CptMonkeyFist/CHIP-GameCape/README.md

# CHIP-GameCape

This is a cape being designed for the CHIP embedded computer. See the LICENSE.txt file for license details.
