CptMonkeyFist/CHIP-GameCape/Breakout.PNG

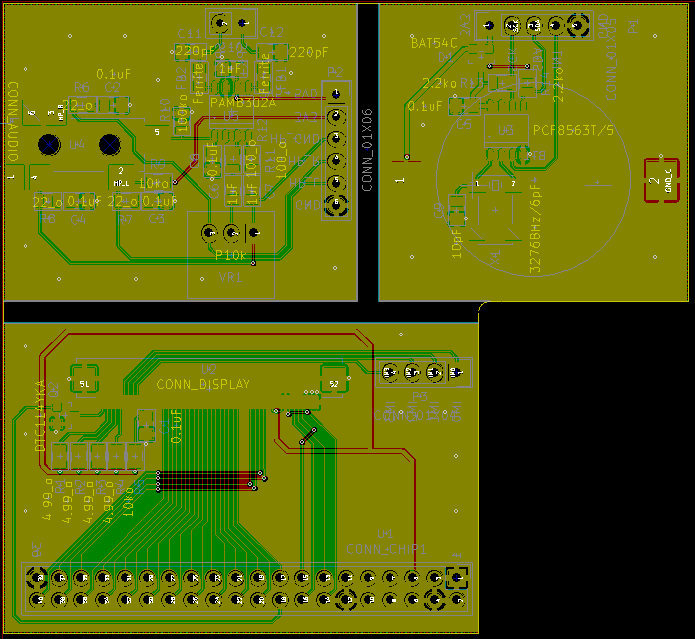
Breakout.PNG
