CptMonkeyFist/CHIP-GameCape/Datasheets/Ref Schematics/RTC_Schem.PNG

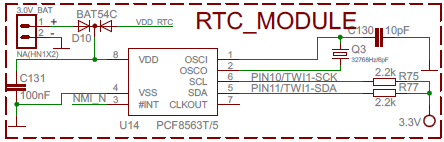
Datasheets/Ref Schematics/RTC_Schem.PNG
