CptMonkeyFist/CHIP-GameCape/Marmoset/Marmoset.xlsx

Reference | Quantity | Value | Footprint | Datasheet | Price | Price (1500) | Price per board | Price per board (1500) | Distributor Part Number | Misc | Manufacturer Part Number
C2, C3, C5, C6, C7, C10 | 6 | 0.1uF | 805 | http://www.digikey.com/product-detail/en/CL21B104KBCNNNC/1276-1003-1-ND/3889089 | 0.1 | 0.0114 | 0.6 | 0.0684 | 1276-1003-1-ND | CAP CER 0.1UF 50V 10% X7R 0805 | CL21B104KBCNNNC
R26, R27 | 2 | 100_o |  | http://www.digikey.com/product-detail/en/ERJ-6ENF1003V/P100KCCT-ND/119551 | 0.1 | 0.00729 | 0.2 | 0.01458 | P100CCT-ND | RES SMD 100 OHM 1% 1/8W 0805 | ERJ-6ENF1000V
R25 | 1 | 100ko |  | http://www.digikey.com/product-detail/en/ERJ-6ENF1003V/P100KCCT-ND/119551 | 0.1 | 0.008 | 0.1 | 0.008 | P100KCCT-ND | RES SMD 100K OHM 1% 1/8W 0805 | ERJ-6ENF1003V
R5, R6, R7, R8, R9, R10, R11, R12, R15, R16, R17, R18, R19, R20, R24 | 15 | 10ko |  | http://www.digikey.com/product-detail/en/ERJ-6ENF1002V/P10.0KCCT-ND/119248 | 0.1 | 0.00675 | 1.5 | 0.10125 | P10.0KCCT-ND | RES SMD 10K OHM 1% 1/8W 0805 | ERJ-6ENF1002V
C4 | 1 | 10pF | 805 | http://www.digikey.com/product-detail/en/CL21C100JBANNNC/1276-1109-1-ND/3889195 | 0.1 | 0.012 | 0.1 | 0.012 | 1276-1109-1-ND | CAP CER 10PF 50V 5% NP0 0805 | CL21C100JBANNNC
C8, C9, C11 | 3 | 1uF | 805 | http://www.digikey.com/product-detail/en/CL21B105KPFNNNE/1276-1275-1-ND/3889361 | 0.1 | 0.01821 | 0.3 | 0.05463 | 1276-1275-1-ND | CAP CER 1UF 10V 10% X7R 0805 | CL21B105KPFNNNE
R13, R14 | 2 | 2.2ko | 805 | http://www.digikey.com/product-detail/en/ERJ-6ENF2201V/P2.20KCCT-ND/1746832 | 0.1 | 0.008 | 0.2 | 0.016 | P2.20KCCT-ND | RES SMD 2.2K OHM 1% 1/8W 0805 | ERJ-6ENF2201V
R21, R22, R23 | 3 | 22_o |  | http://www.digikey.com/product-detail/en/ERJ-6ENF22R0V/P22.0CCT-ND/1746835 | 0.1 | 0.008 | 0.3 | 0.024 | P22.0CCT-ND | RES SMD 22 OHM 1% 1/8W 0805 | ERJ-6ENF22R0V
C12, C13 | 2 | 220pF | 805 | http://www.digikey.com/product-detail/en/samsung-electro-mechanics-america-inc/CL21C221JBANNNC/1276-1164-1-ND/3889250 | 0.1 | 0.015 | 0.2 | 0.03 | 1276-1164-1-ND | CAP CER 220pF 50V 5% X7R 0805 | CL21C221JBANNNC
X1 | 1 | 32768Hz/6pF |  | http://www.digikey.com/product-detail/en/ABS25-32.768KHZ-6-T/535-10240-1-ND/2218053 | 0.6 | 0.3192 | 0.6 | 0.3192 | 535-10240-1-ND |  | ABS25-32.768KHZ-6-T
C1 | 1 | 4.7uF |  | http://www.digikey.com/product-detail/en/CL21A475KQFNNNE/1276-1198-1-ND/3889284 | 0.14 | 0.0264 | 0.14 | 0.0264 | 1276-1198-1-ND | CAP CER 4.7UF 6.3V 10% X5R 0805 | CL21A475KQFNNNE
R1, R2, R3, R4 | 4 | 4.99_o | 805 | http://www.digikey.com/product-detail/en/RC2012F4R99CS/1276-5173-1-ND/3968145 | 0.1 | 0.00408 | 0.4 | 0.01632 | 1276-5173-1-ND | RES SMD 4.99 OHM 1% 1/8W 0805 | RC2012F4R99CS
D1 | 1 | BAT54C | SOT-23 | http://www.digikey.com/product-detail/en/BAT54C-7-F/BAT54C-FDICT-ND/717821 | 0.2 | 0.04017 | 0.2 | 0.04017 | BAT54C-FDICT-ND |  | BAT54C-7-F
BT1 | 1 | BATT_2032 |  | http://www.digikey.com/product-detail/en/BU2032SM-BT-GTR/BU2032SM-BT-GTR-ND/2439521 | 0.6 | 0.35 | 0.6 | 0.35 | BU2032SM-BT-GCT-ND | BU2032SM-BT-GTR-ND | BU2032SM-BT-GTR
U6 | 1 | CONN_AUDIO |  | http://www.digikey.com/product-detail/en/SJ-43515TS-SMT-TR/CP-43515TSSJCT-ND/669733 | 1.54 | 0.5888 | 1.54 | 0.5888 | CP-43515TSSJCT-ND | CP-43515TSSJTR-ND | SJ-43515TS-SMT-TR
U3 | 1 | CONN_BATT |  | http://www.digikey.com/product-detail/en/S2B-PH-K-S(LF)(SN)/455-1719-ND/926626 | 0.16 | 0.06836 | 0.16 | 0.06836 | 455-1719-ND | JST PH Right Angle | S2B-PH-K-S(LF)(SN)
U1 | 1 | CONN_CHIP1 |  | http://www.digikey.com/product-detail/en/M20-9762042/952-1895-ND/3727862 | 1.31 | 0.7216 | 1.31 | 0.7216 | 952-1895-ND | 2x20 0.1" | M20-9762042
U2 | 1 | CONN_CHIP2 |  | http://www.digikey.com/product-detail/en/M20-9762042/952-1895-ND/3727862 | 1.31 | 0.7216 | 1.31 | 0.7216 | 952-1895-ND | 2x20 0.1" | M20-9762042
U4 | 1 | CONN_DISPLAY |  | http://www.digikey.com/product-detail/en/62684-502100ALF/609-1202-1-ND/1003059 | 1.35 | 0.74712 | 1.35 | 0.74712 | 609-1202-1-ND |  | 62684-502100ALF
Q1, Q2 | 2 | DTC114YKA |  | http://www.digikey.com/product-detail/en/DTC114YKAT146/DTC114YKAT146CT-ND/650713 | 0.2 | 0.04017 | 0.4 | 0.08034 | DTC114YKAT146CT-ND |  | DTC114YKAT146
FB1, FB2 | 2 | Ferrite | 805 | http://www.digikey.com/product-detail/en/murata-electronics-north-america/BLM21PG121SH1D/490-12626-1-ND/5797605 | 0.17 | 0.04686 | 0.34 | 0.09372 | 490-12626-1-ND | 120 OHM @ 100 MHz 0805 3A 30mOhm | BLM21PG121SH1D
U7 | 1 | PAM8302A | SOP-8 | http://www.mouser.com/ProductDetail/Diodes-Incorporated/PAM8302AADCR/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 | 0.67 | 0.238 | 0.67 | 0.238 | 621-PAM8302AADCR | Mono Amplifier | PAM8302AADCR
U5 | 1 | PCF8563T/5 |  | http://www.digikey.com/product-detail/en/PCF8563T%2F5 | 1.21 | 0.5208 | 1.21 | 0.5208 | 568-6650-1-ND | RTC | PCF8563T/5,518/568-6650-1-ND/2617089
RV1 | 1 | POT |  | http://www.digikey.com/product-search/en/potentiometers-variable-resistors/thumbwheel-potentiometers/262240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 | 1.19 | 0.6475 | 1.19 | 0.6475 | 987-1167-ND | TRIMMER 10K OHM 3/8" CERMET TH | 91AR10KLF
SP1 | 1 | SPEAKER |  | http://www.digikey.com/product-detail/en/2403%20260%2000001/423-1171-ND/3854649 | 1.89 | 0.88518 | 1.89 | 0.88518 | 423-1171-ND |  | 2403 260 00001
BTN_UP1, BTN_DOWN1, BTN_LEFT1, BTN_RIGHT1, BTN_A1, BTN_B1, BTN_X1, BTN_Y1, BTN_START1, BTN_SEL1, BTN_POWER1, BTN_HOME1 | 12 | SW_TACT |  | http://www.digikey.com/product-detail/en/PTS525SM10SMTR%20LFS/CKN9104CT-ND/1146923 | 0.65 | 0.3498 | 7.8 | 4.1976 | CKN9104CT-ND |  | PTS525SM10SMTR LFS
BTN_L1, BTN_R1 | 2 | SW_TACT_RA |  | http://www.digikey.com/product-detail/en/B3F-3120/SW407-ND/38364 | 0.54 | 0.28995 | 1.08 | 0.5799 | SW407-ND |  | B3F-3120
Touch Screen Display | 1 |  |  | http://www.adafruit.com/products/1774 | 17.95 | 14 | 17.95 | 14 |  | Price (1500 Guess)
CHIP Computer | 1 |  |  | http://getchip.com | 9 |  | 9 | 0
Battery (2800mah) | 1 |  |  | https://www.adafruit.com/products/328 | 14.95 | 10 | 14.95 | 10 |  | Price (1500 Guess)
Injection molded case/buttons | 1 |  |  |  | 5 | 5 | 5 | 5
 |  |  |  |  |  | Total | 72.59 | 40.17147
