CptMonkeyFist/CHIP-GameCape/Schematic.pdf

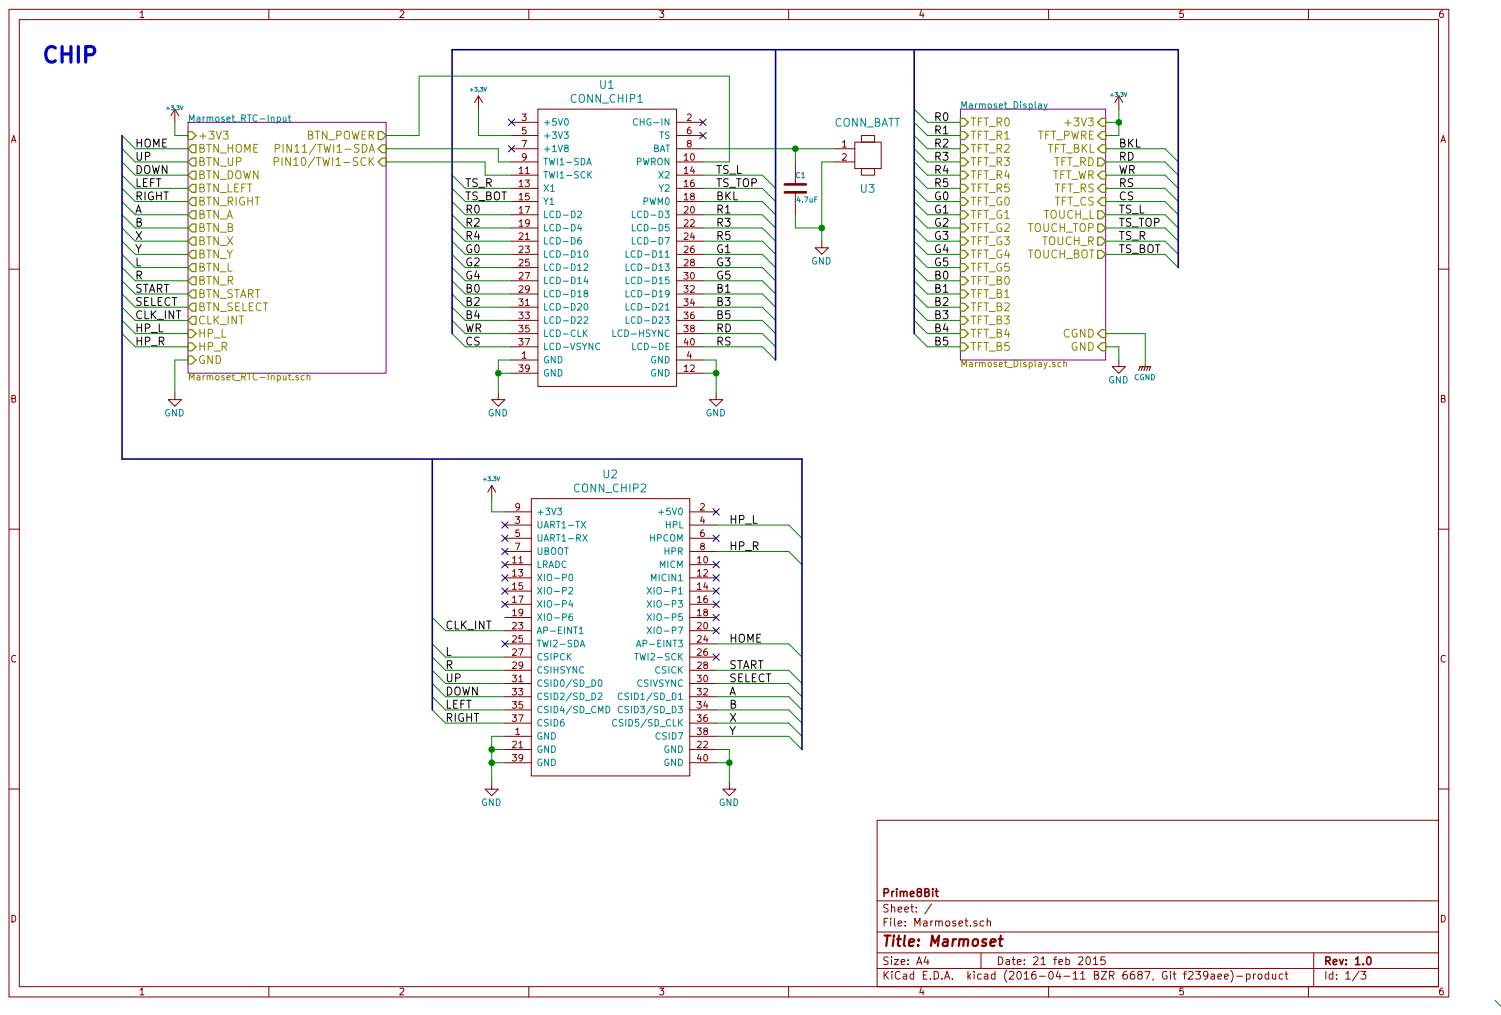
[picture p3: page 1]

Id: 1/3 Title: Marmoset File: Marmoset.sch Sheet: / Prime8Bit

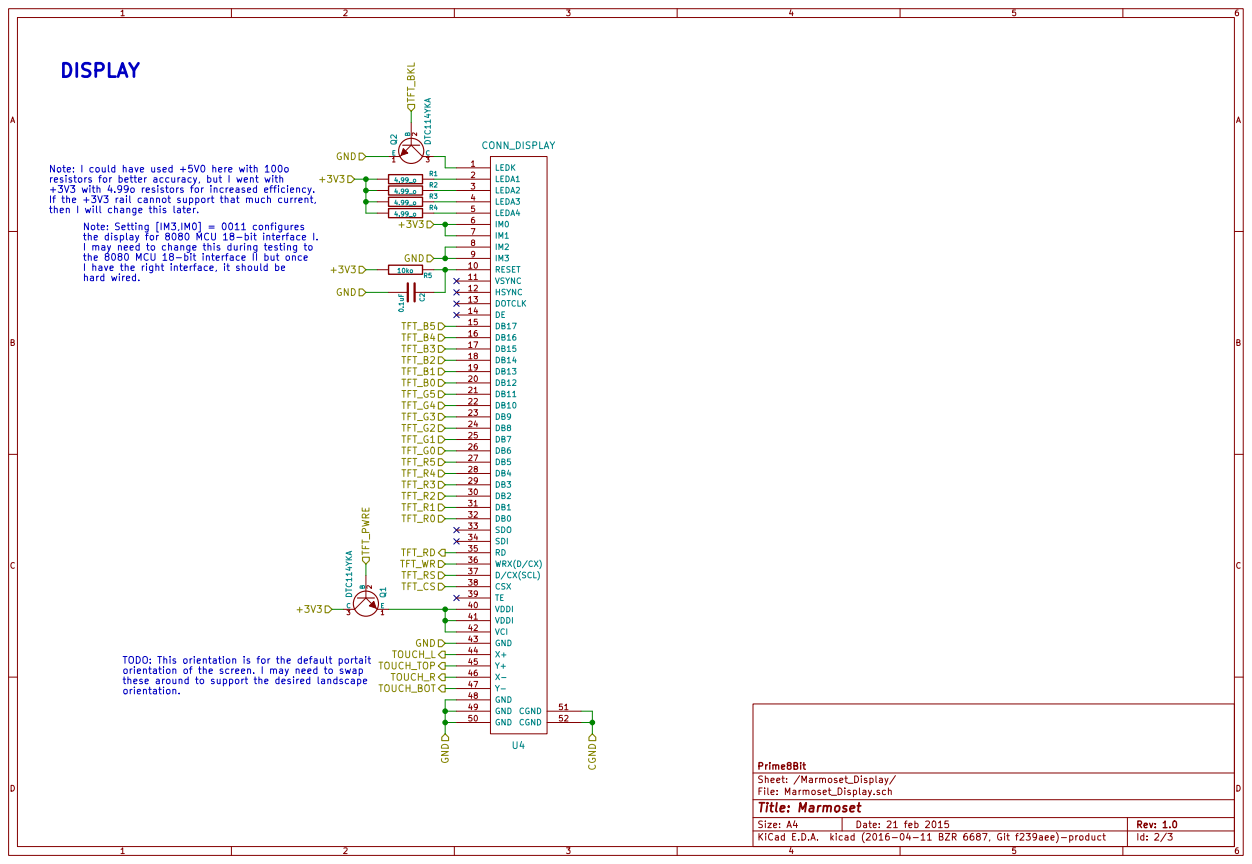
[picture p4: page 2]

Note: I could have used +5V0 here with 100o
resistors for better accuracy, but I went with
+3V3 with 4.99o resistors for increased efficiency.
If the +3V3 rail cannot support that much current,

Note: Setting [IM3,IM0] = 0011 configures
the display for 8080 MCU 18-bit interface I.
I may need to change this during testing to
the 8080 MCU 18-bit interface II but once
I have the right interface, it should be hard wired. TODO: This orientation is for the default portait

orientation of the screen. I may need to swap
these around to support the desired landscape orientation.

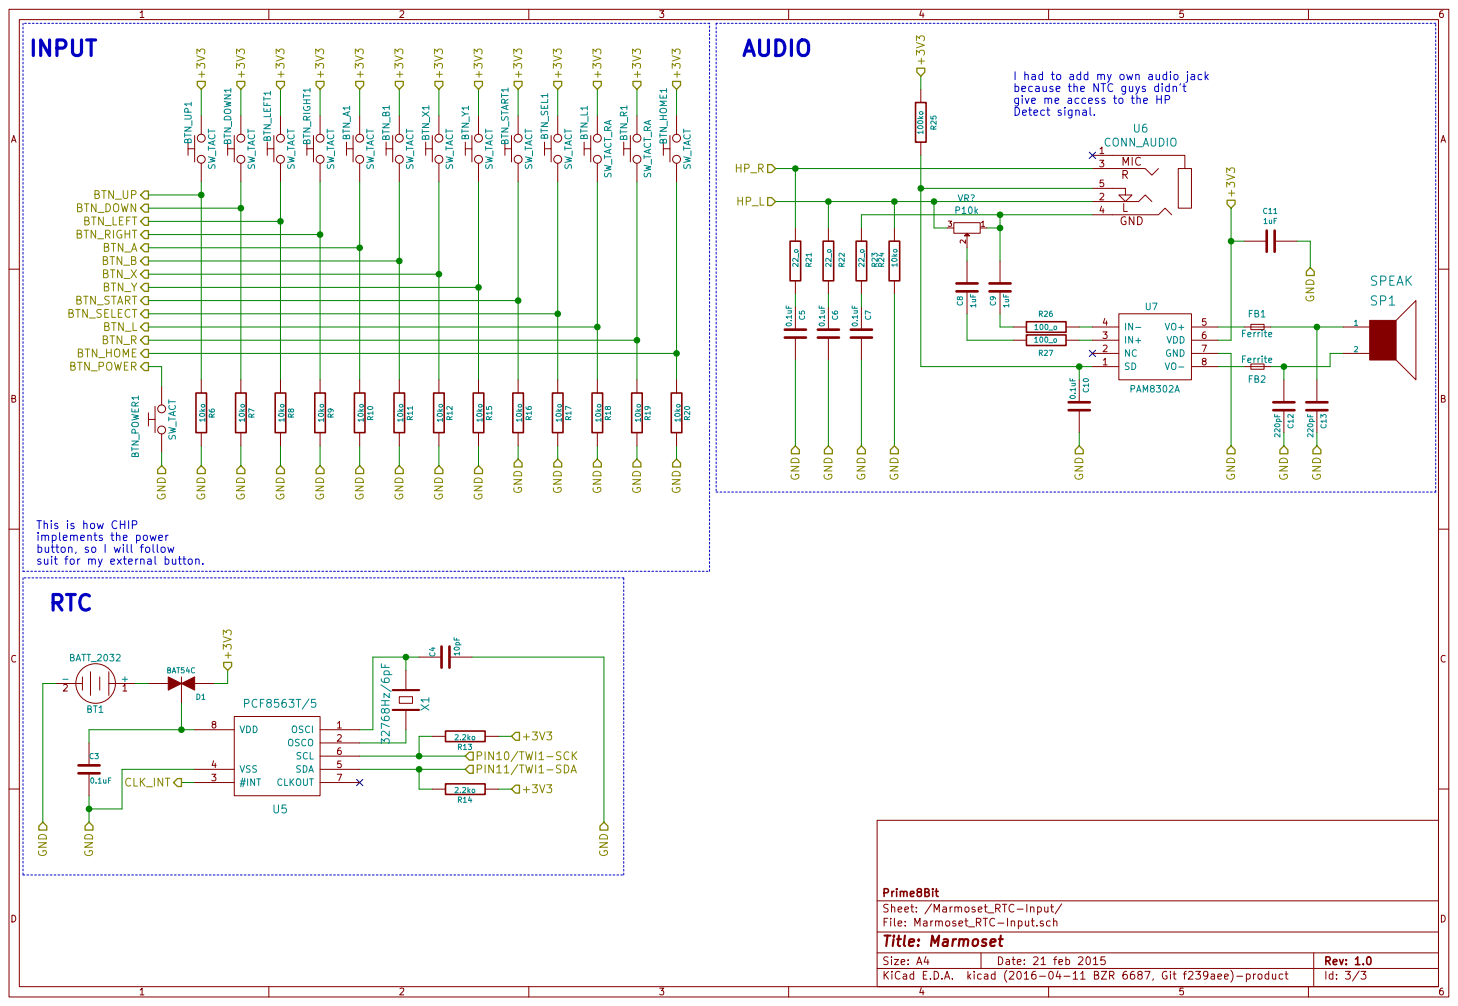
[picture p5: page 3]

I had to add my own audio jack
because the NTC guys didn't
give me access to the HP
Detect signal.

This is how CHIP
implements the power
button, so I will follow
suit for my external button.
RTC
