CptMonkeyFist/CHIP-GameCape/Marmoset_Breakout_Schem.pdf

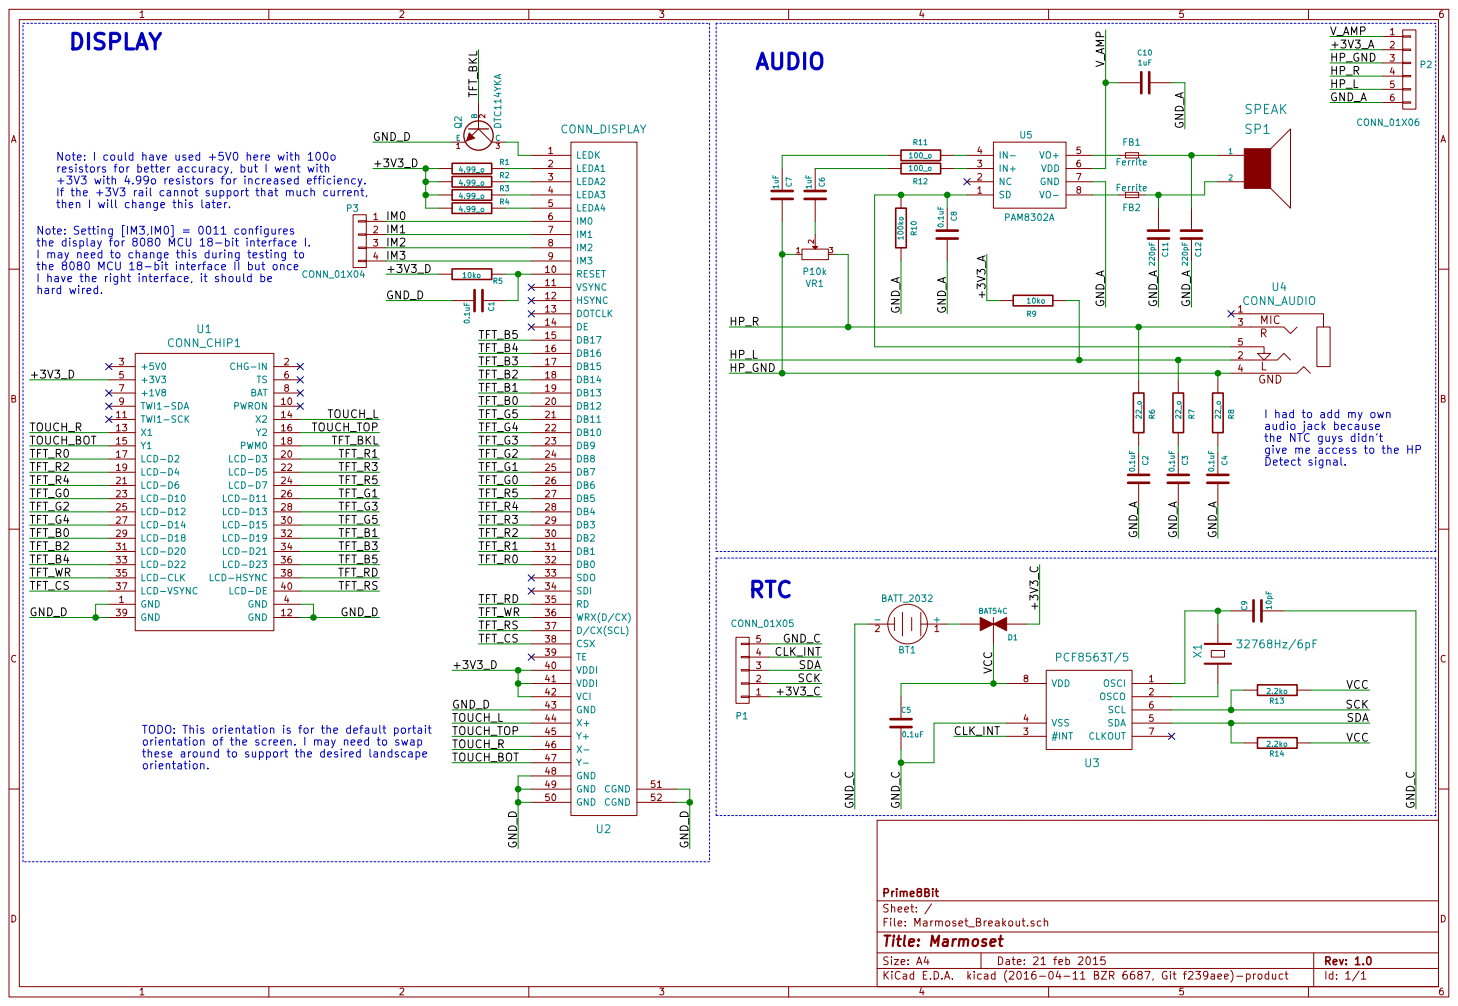
[picture p6: page 1]
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

4 P3 CONN_01X04 2 | IM1 | IM1 7

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

3 | IM2 | IM2 8
IM3

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

TFT_WR | | TFT_RD
TFT_CS | TFT_RS

TOUCH_L
TOUCH_TOP
TOUCH_R
TOUCH_BOT

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
