CptMonkeyFist/CHIP-GameCape/Marmoset_B.pdf

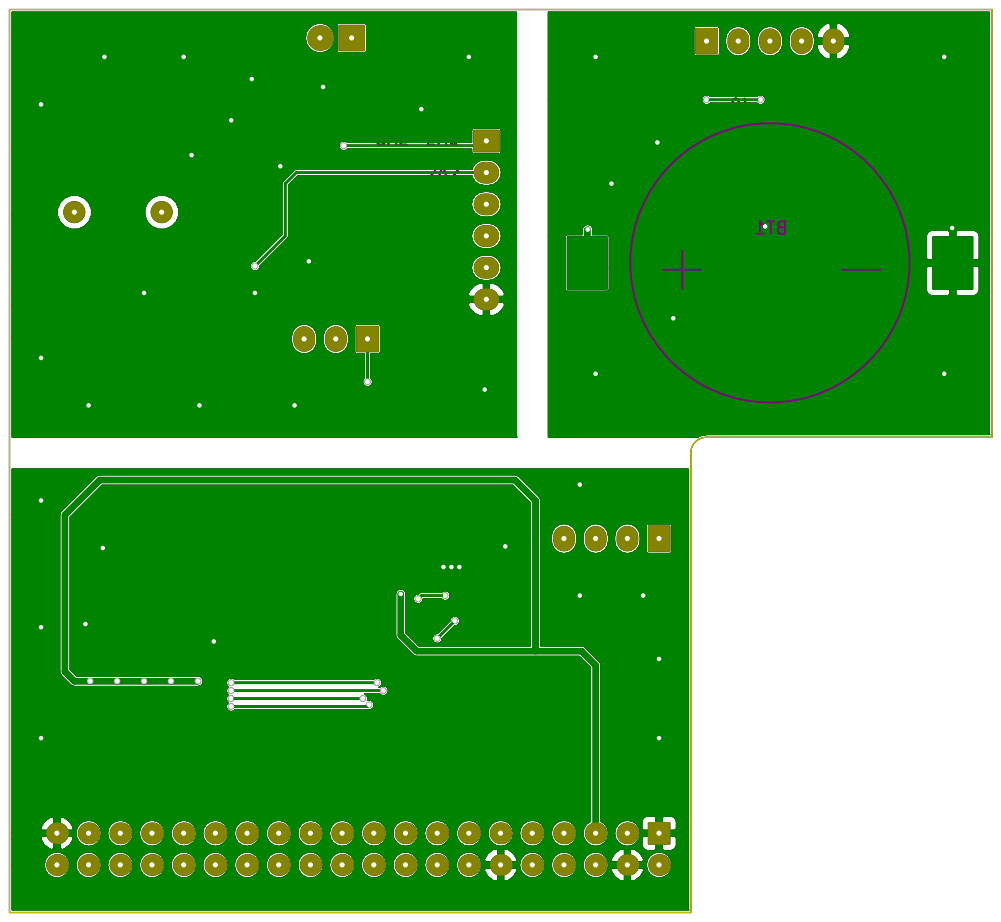
[picture p7: page 1]
