CptMonkeyFist/CHIP-GameCape/Marmoset_F.pdf

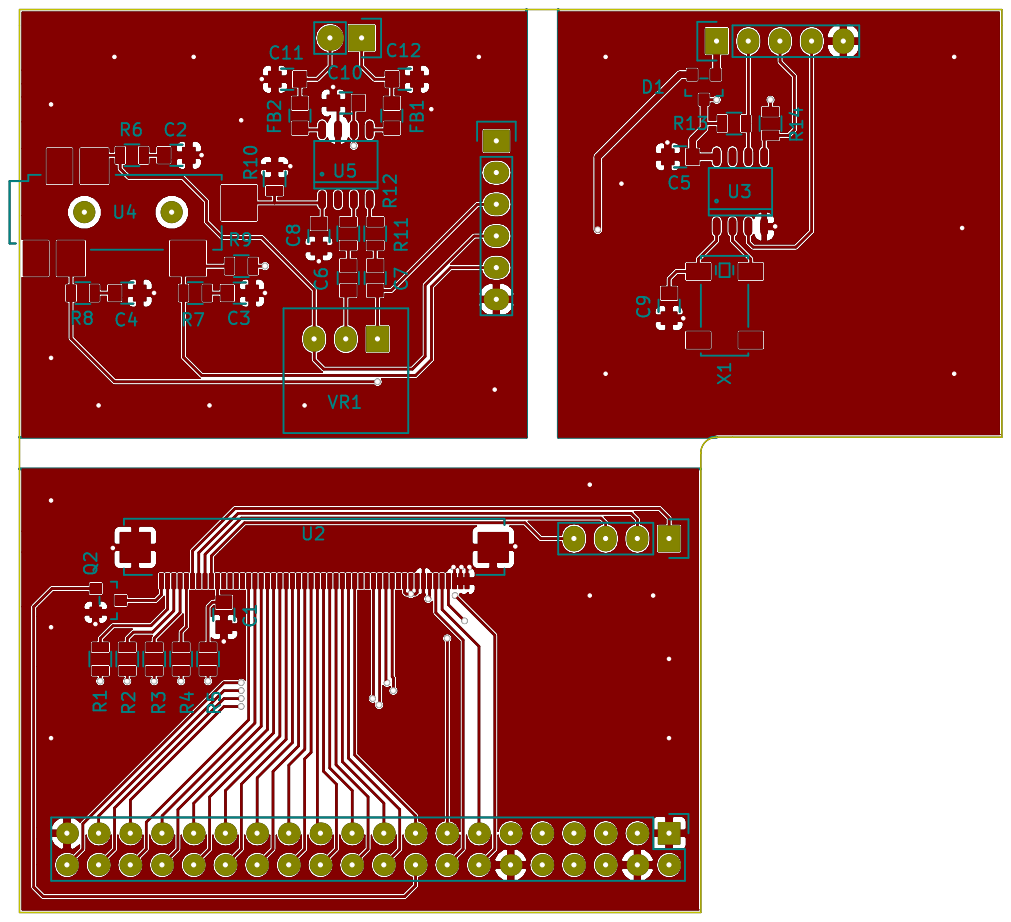
[picture p8: page 1]
