CptMonkeyFist/CHIP-GameCape/Marmoset_Breakout/Marmoset_Breakout.kicad_pcb

## KiCad design Marmoset_Breakout/Marmoset_Breakout.kicad_pcb (2016-07-28)

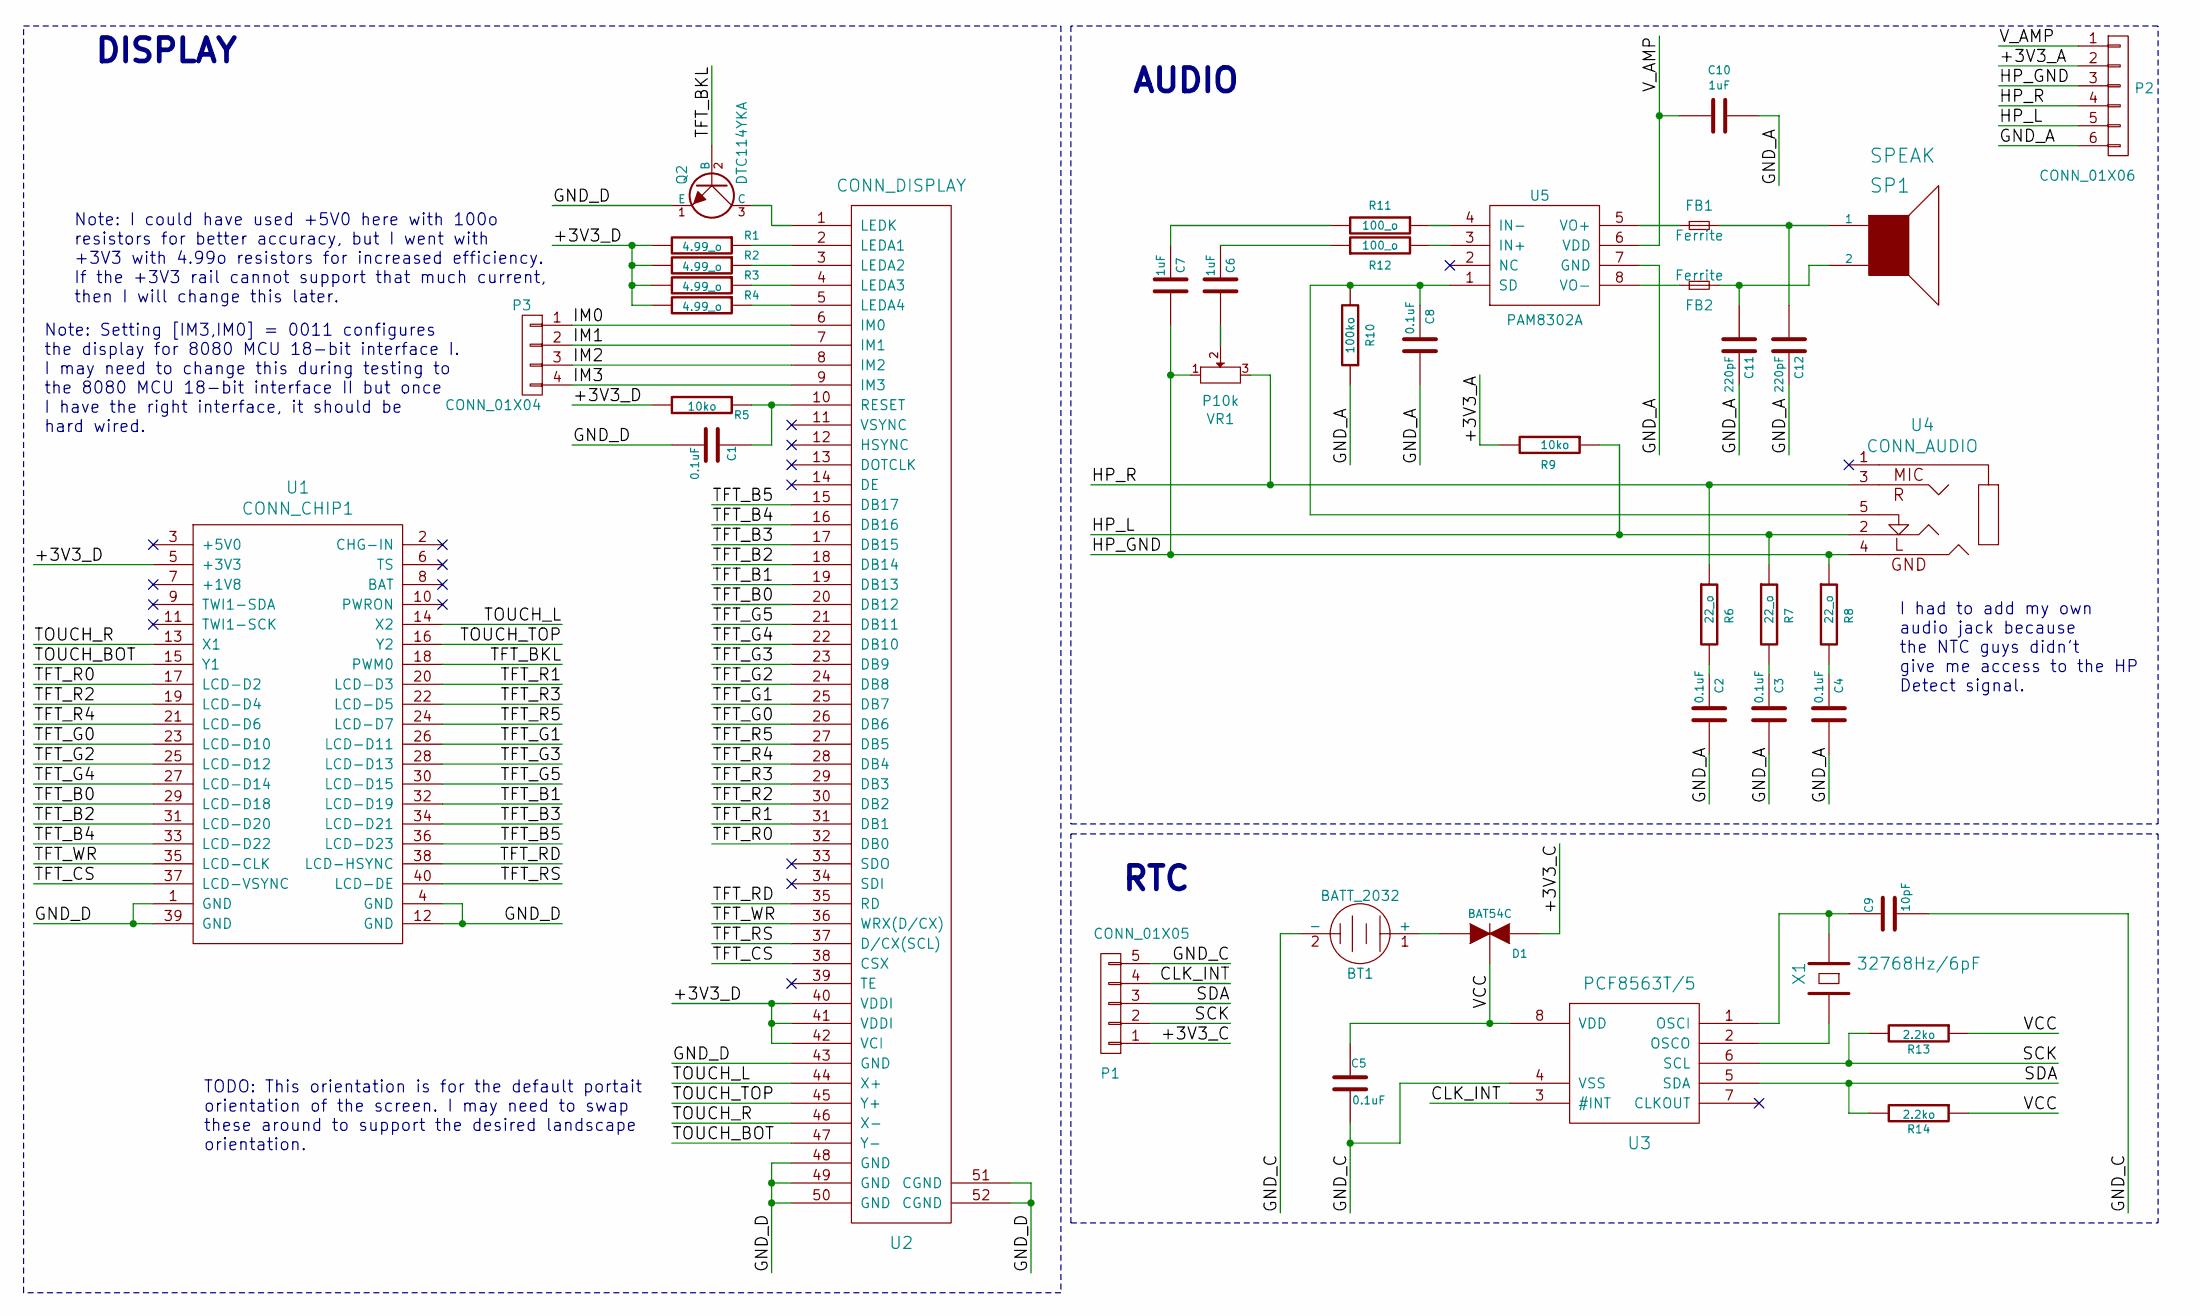
[picture p9: schematic Marmoset_Breakout.sch, Marmoset]

Parts:
BT1: BATT_2032; SMTU2032-LF; Manufacturer Part Number BU2032SM-BT-GTR
C1, C2, C3, C4, C5, C8: 0.1uF; C_0805; Manufacturer Part Number CL21B104KBCNNNC
C6, C7, C10: 1uF; C_0805; Manufacturer Part Number CL21B105KPFNNNE
C9: 10pF; C_0805; Manufacturer Part Number CL21C100JBANNNC
C11, C12: 220pF; C_0805; Manufacturer Part Number CL21C221JBANNNC
D1: BAT54C; SOT-23-3; Manufacturer Part Number BAT54C-7-F
FB1, FB2: Ferrite; C_0805; Manufacturer Part Number BLM21PG121SH1D
P1: CONN_01X05; Pin_Header_Straight_1x05
P2: CONN_01X06; Pin_Header_Straight_1x06
P3: CONN_01X04; Pin_Header_Straight_1x04
Q2: DTC114YKA; SOT-23-3; Manufacturer Part Number DTC114YKAT146
R1, R2, R3, R4: 4.99_o; R_0805; Manufacturer Part Number RC2012F4R99CS
R5, R9: 10ko; R_0805; Manufacturer Part Number ERJ-6ENF1002V
R6, R7, R8: 22_o; R_0805; Manufacturer Part Number ERJ-6ENF22R0V
R10: 100ko; R_0805; Manufacturer Part Number ERJ-6ENF1003V
R11, R12: 100_o; R_0805; Manufacturer Part Number ERJ-6ENF1000V
R13, R14: 2.2ko; R_0805; Manufacturer Part Number ERJ-6ENF2201V
SP1: SPEAK; Pin_Header_Straight_1x02; Manufacturer Part Number 2403 260 00001
U1: CONN_CHIP1; Pin_Header_Straight_2x20; Manufacturer Part Number M20-9762042
U2: CONN_DISPLAY; Manufacturer Part Number 62684-502100ALF
U3: PCF8563T/5; SO-8; Manufacturer Part Number PCF8563T/5
U4: CONN_AUDIO; CONN_HP; Manufacturer Part Number SJ-43515TS-SMT-TR
U5: PAM8302A; SO-8; Manufacturer Part Number PAM8302AADCR
VR1: P10k; Thumb_Pot; Manufacturer Part Number 91AR10KLF
X1: 32768Hz/6pF; ABS25; Manufacturer Part Number ABS25-32.768KHZ-6-T

Connections:
/+3V3_A: P2.2, R9.2
/+3V3_C: D1.2 (A), P1.1
/+3V3_D: R1.2, R2.2, R3.2, R4.2, R5.2, U1.5 (+3V3), U2.40 (VDDI), U2.41 (VDDI), U2.42 (VCI)
/CLK_INT: P1.4, U3.3 (#INT)
/GND_A: C2.2, C3.2, C4.2, C8.2, C10.1, C11.1, C12.1, P2.6, R10.1, U5.7 (GND)
/GND_C: BT1.2 (-), C5.2, C9.2, P1.5, U3.4 (VSS)
/GND_D: C1.2, Q2.1 (E), U1.1 (GND), U1.4 (GND), U1.12 (GND), U1.39 (GND), U2.43 (GND), U2.48 (GND), U2.49 (GND), U2.50 (GND), U2.51 (CGND), U2.52 (CGND)
/HP_GND: C7.2, P2.3, R8.1, U4.4, VR1.1
/HP_L: P2.5, R7.1, R9.1, U4.2
/HP_R: P2.4, R6.1, U4.3, VR1.3
/IM0: P3.1, U2.6 (IM0)
/IM1: P3.2, U2.7 (IM1)
/IM2: P3.3, U2.8 (IM2)
/IM3: P3.4, U2.9 (IM3)
/SCK: P1.2, R13.2, U3.6 (SCL)
/SDA: P1.3, R14.2, U3.5 (SDA)
/TFT_B0: U1.29 (LCD-D18), U2.20 (DB12)
/TFT_B1: U1.32 (LCD-D19), U2.19 (DB13)
/TFT_B2: U1.31 (LCD-D20), U2.18 (DB14)
/TFT_B3: U1.34 (LCD-D21), U2.17 (DB15)
/TFT_B4: U1.33 (LCD-D22), U2.16 (DB16)
/TFT_B5: U1.36 (LCD-D23), U2.15 (DB17)
/TFT_BKL: Q2.2 (B), U1.18 (PWM0)
/TFT_CS: U1.37 (LCD-VSYNC), U2.38 (CSX)
/TFT_G0: U1.23 (LCD-D10), U2.26 (DB6)
/TFT_G1: U1.26 (LCD-D11), U2.25 (DB7)
/TFT_G2: U1.25 (LCD-D12), U2.24 (DB8)
/TFT_G3: U1.28 (LCD-D13), U2.23 (DB9)
/TFT_G4: U1.27 (LCD-D14), U2.22 (DB10)
/TFT_G5: U1.30 (LCD-D15), U2.21 (DB11)
/TFT_R0: U1.17 (LCD-D2), U2.32 (DB0)
/TFT_R1: U1.20 (LCD-D3), U2.31 (DB1)
/TFT_R2: U1.19 (LCD-D4), U2.30 (DB2)
/TFT_R3: U1.22 (LCD-D5), U2.29 (DB3)
/TFT_R4: U1.21 (LCD-D6), U2.28 (DB4)
/TFT_R5: U1.24 (LCD-D7), U2.27 (DB5)
/TFT_RD: U1.38 (LCD-HSYNC), U2.35 (RD)
/TFT_RS: U1.40 (LCD-DE), U2.37 (D/CX(SCL))
/TFT_WR: U1.35 (LCD-CLK), U2.36 (WRX(D/CX))
/TOUCH_BOT: U1.15 (Y1), U2.47 (Y-)
/TOUCH_L: U1.14 (X2), U2.44 (X+)
/TOUCH_R: U1.13 (X1), U2.46 (X-)
/TOUCH_TOP: U1.16 (Y2), U2.45 (Y+)
/VCC: C5.1, D1.3 (K), R13.1, R14.1, U3.8 (VDD)
/V_AMP: C10.2, P2.1, U5.6 (VDD)
unnamed: BT1.1 (+), D1.1 (A)
unnamed: C1.1, R5.1, U2.10 (RESET)
unnamed: C2.1, R6.2
unnamed: C3.1, R7.2
unnamed: C4.1, R8.2
unnamed: C6.1, R12.1
unnamed: C6.2, VR1.2
unnamed: C7.1, R11.2
unnamed: C8.1, R10.2, U4.5, U5.1 (SD)
unnamed: C9.1, U3.1 (OSCI), X1.1
unnamed: C11.2, FB2.2, SP1.2
unnamed: C12.2, FB1.2, SP1.1
unnamed: FB1.1, U5.5 (VO+)
unnamed: FB2.1, U5.8 (VO-)
unnamed: Q2.3 (C), U2.1 (LEDK)
unnamed: R1.1, U2.2 (LEDA1)
unnamed: R2.1, U2.3 (LEDA2)
unnamed: R3.1, U2.4 (LEDA3)
unnamed: R4.1, U2.5 (LEDA4)
unnamed: R11.1, U5.4 (IN-)
unnamed: R12.2, U5.3 (IN+)
unnamed: U3.2 (OSCO), X1.2

Notes on the sheet:
Note: Setting [IM3,IM0] = 0011 configures the display for 8080 MCU 18-bit interface I. I may need to change this during testing to the 8080 MCU 18-bit interface II but once I have the right interface, it should be hard wired.
TODO: This orientation is for the default portait orientation of the screen. I may need to swap these around to support the desired landscape orientation.
Note: I could have used +5V0 here with 100o resistors for better accuracy, but I went with +3V3 with 4.99o resistors for increased efficiency. If the +3V3 rail cannot support that much current, then I will change this later.
DISPLAY
AUDIO
I had to add my own audio jack because the NTC guys didn't give me access to the HP Detect signal.
RTC

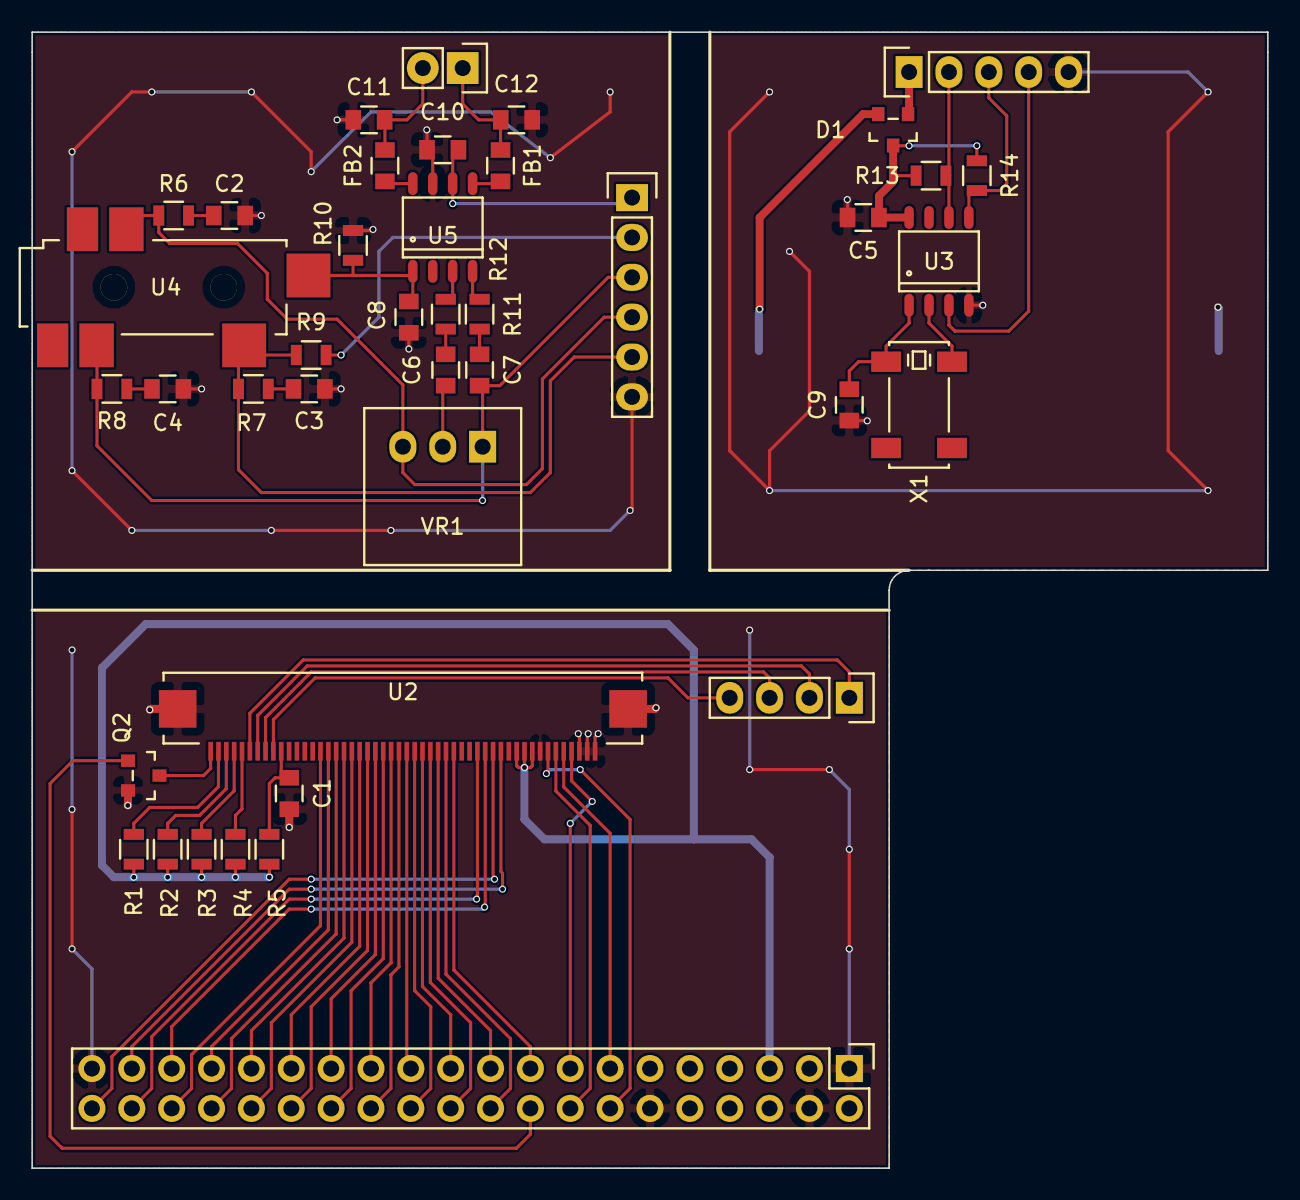
[picture p10: board Marmoset_Breakout.kicad_pcb from above]

Board: 2 copper layers, 78.7 x 72.4 mm, 42 parts (1 on the bottom side), 67 nets.
