CptMonkeyFist/CHIP-GameCape/Marmoset_Breakout/Marmoset.kicad_pcb

## KiCad design Marmoset_Breakout/Marmoset.kicad_pcb (2016-06-14)

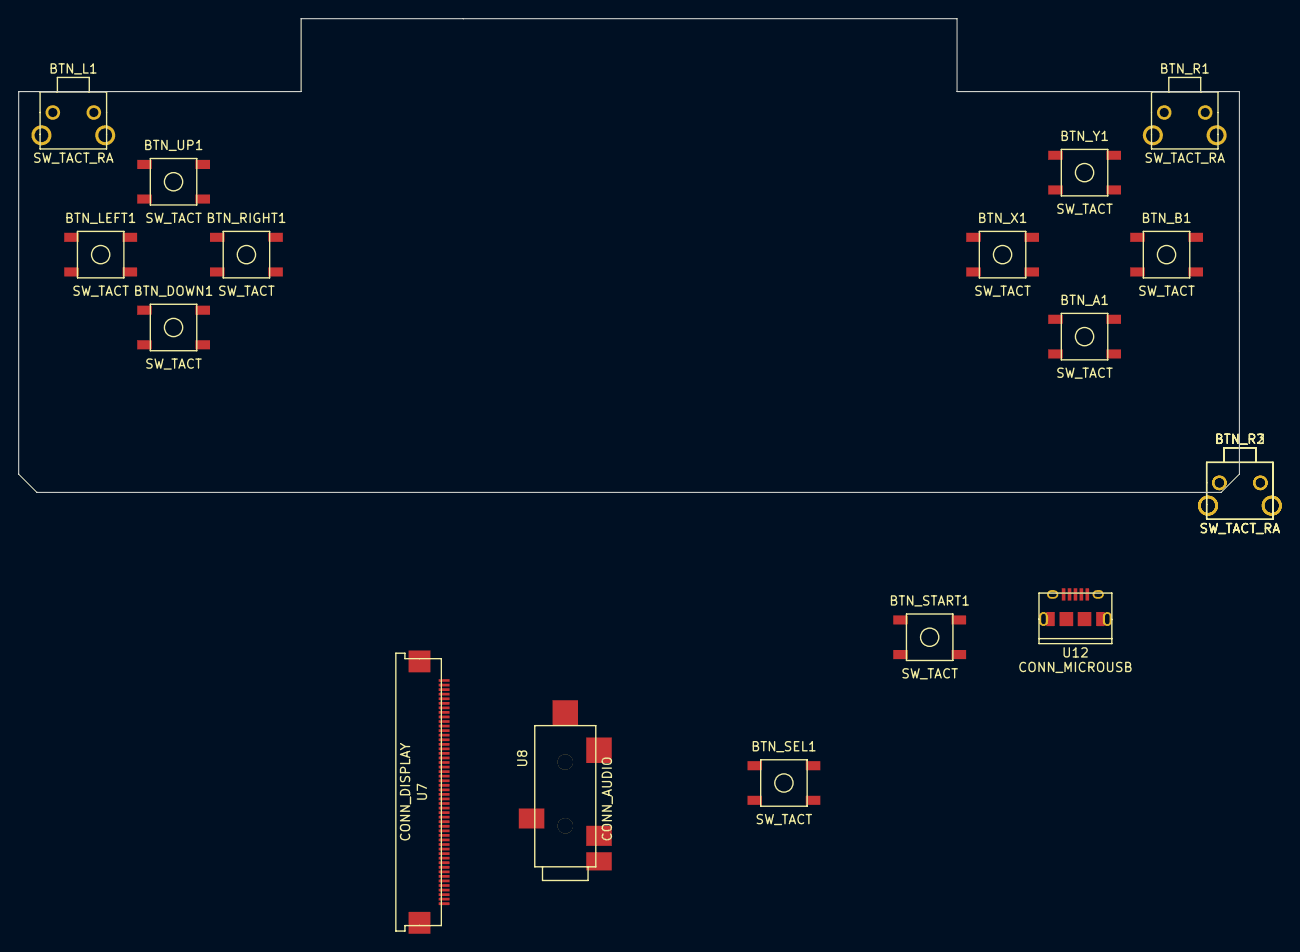
[picture p11: board Marmoset.kicad_pcb from above]

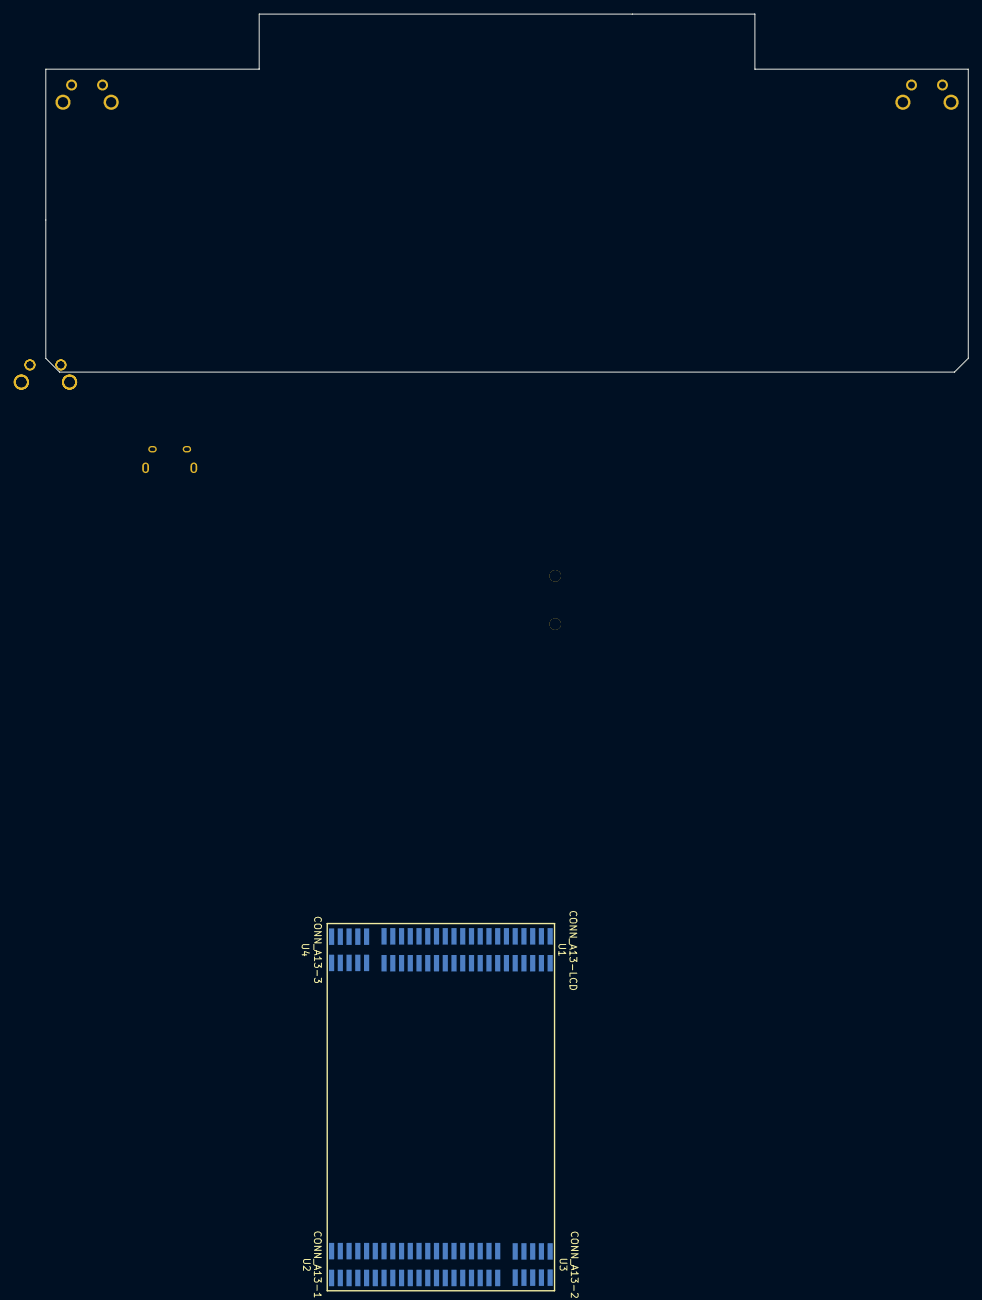
[picture p12: board Marmoset.kicad_pcb from below]

Board: 2 copper layers, 134.0 x 52.0 mm, 21 parts (4 on the bottom side), 47 nets, no tracks yet.

Parts:
BTN_A1: SW_TACT
BTN_B1: SW_TACT
BTN_DOWN1: SW_TACT
BTN_L1: SW_TACT_RA
BTN_LEFT1: SW_TACT
BTN_R1, BTN_R2, BTN_R3: SW_TACT_RA
BTN_RIGHT1: SW_TACT
BTN_SEL1: SW_TACT
BTN_START1: SW_TACT
BTN_UP1: SW_TACT
BTN_X1: SW_TACT
BTN_Y1: SW_TACT
U1: CONN_A13-LCD; CONN_A13_2x20
U2: CONN_A13-1; CONN_A13_2x20
U3: CONN_A13-2; CONN_A13_2x5
U4: CONN_A13-3; CONN_A13_2x5
U7: CONN_DISPLAY
U8: CONN_AUDIO
U12: CONN_MICROUSB

Connections:
/Marmoset_Display/+3V3: U1.3, U7.6, U7.7
/Marmoset_Display/CGND: U7.51, U7.52
/Marmoset_Display/TFT_B0: U1.23, U7.20
/Marmoset_Display/TFT_B1: U1.24, U7.19
/Marmoset_Display/TFT_B2: U1.25, U7.18
/Marmoset_Display/TFT_B3: U1.26, U7.17
/Marmoset_Display/TFT_B4: U1.27, U7.16
/Marmoset_Display/TFT_B5: U1.28, U7.15
/Marmoset_Display/TFT_CS: U1.30, U7.38
/Marmoset_Display/TFT_G0: U1.15, U7.26
/Marmoset_Display/TFT_G1: U1.16, U7.25
/Marmoset_Display/TFT_G2: U1.17, U7.24
/Marmoset_Display/TFT_G3: U1.18, U7.23
/Marmoset_Display/TFT_G4: U1.19, U7.22
/Marmoset_Display/TFT_G5: U1.20, U7.21
/Marmoset_Display/TFT_R0: U1.7, U7.32
/Marmoset_Display/TFT_R1: U1.8, U7.31
/Marmoset_Display/TFT_R2: U1.9, U7.30
/Marmoset_Display/TFT_R3: U1.10, U7.29
/Marmoset_Display/TFT_R4: U1.11, U7.28
/Marmoset_Display/TFT_R5: U1.12, U7.27
/Marmoset_Display/TFT_RD: U1.29, U7.35
/Marmoset_Display/TFT_RS: U1.32, U7.37
/Marmoset_Display/TFT_WR: U1.31, U7.36
/Marmoset_Display/TOUCH_BOT: U1.39, U7.47
/Marmoset_Display/TOUCH_L: U1.38, U7.44
/Marmoset_Display/TOUCH_R: U1.37, U7.46
/Marmoset_Display/TOUCH_TOP: U1.40, U7.45
/Marmoset_PWR-USB/UDP0: U3.1, U12.3
/Marmoset_Wifi-Input/+3V3: BTN_A1.2, BTN_B1.2, BTN_DOWN1.2, BTN_L1.2, BTN_LEFT1.2, BTN_R1.2, BTN_R2.2, BTN_R3.2, BTN_RIGHT1.2, BTN_SEL1.2, BTN_START1.2, BTN_UP1.2, BTN_X1.2, BTN_Y1.2
/Marmoset_Wifi-Input/BTN_A: BTN_A1.1, U2.6
/Marmoset_Wifi-Input/BTN_B: BTN_B1.1, U2.8
/Marmoset_Wifi-Input/BTN_DOWN: BTN_DOWN1.1, U2.11
/Marmoset_Wifi-Input/BTN_L: BTN_L1.1, U2.14
/Marmoset_Wifi-Input/BTN_LEFT: BTN_LEFT1.1, U2.13
/Marmoset_Wifi-Input/BTN_R: BTN_R1.1, U2.16
/Marmoset_Wifi-Input/BTN_RIGHT: BTN_RIGHT1.1, U2.15
/Marmoset_Wifi-Input/BTN_SELECT: BTN_SEL1.1, U2.20
/Marmoset_Wifi-Input/BTN_START: BTN_START1.1, U2.18
/Marmoset_Wifi-Input/BTN_UP: BTN_UP1.1, U2.9
/Marmoset_Wifi-Input/BTN_VOL+: BTN_R2.1, U2.22
/Marmoset_Wifi-Input/BTN_VOL-: BTN_R3.1, U2.24
/Marmoset_Wifi-Input/BTN_X: BTN_X1.1, U2.10
/Marmoset_Wifi-Input/BTN_Y: BTN_Y1.1, U2.12
GND: U1.2, U1.4, U2.2, U7.8, U7.9, U7.43, U7.48, U7.49, U7.50
GNDPWR: U12.6, U12.7, U12.8, U12.9
unnamed: U7.40, U7.41, U7.42
