CptMonkeyFist/CHIP-GameCape/(commit log)

2016-06-20 Added Breakout board KiCad project.
    [Marmoset.csv, Marmoset.kicad_pcb, Marmoset.xlsx, Marmoset_Audio.sch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]
2016-06-20 Added Breakout Schematic
2016-07-08 Fixed unconnected LCD Power Enable signal. Fixed audio schematic and redid layout accordingly.
    [Marmoset_Breakout-B.Cu.gbl, Marmoset_Breakout-B.Mask.gbs, Marmoset_Breakout-B.SilkS.gbo, Marmoset_Breakout-Edge.Cuts.gm1, Marmoset_Breakout-F.Cu.gtl, Marmoset_Breakout-F.Mask.gts, Marmoset_Breakout-F.SilkS.gto, Marmoset_Breakout.drl]
2016-07-08 Fixed Shutdown circuit for audio amp to use negative logic (as specified in datasheet) Fixed debouncing circuit for headphone ground pin. Added another pin to audio board to allow me to choose voltag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
    [Marmoset_Breakout.kicad_pcb, Marmoset_Breakout.sch]
2016-07-28 Changed Speaker used and updated BOM/Schematic.
    [Marmoset.csv, Marmoset.xlsx, Marmoset_Breakout.kicad_pcb, Marmoset_Breakout.sch]
